nikon-63/Robot_LawnMower/Code/Python/tractor.jpg

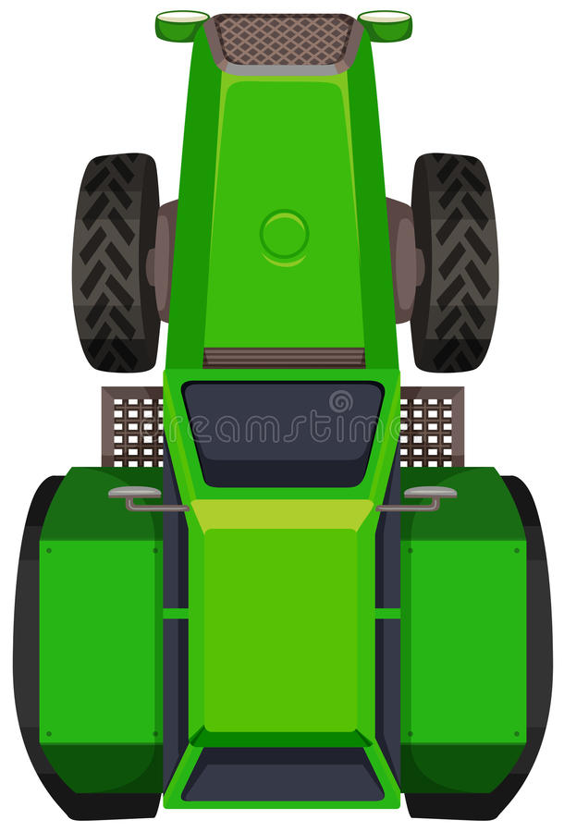
Code/Python/tractor.jpg
