nikon-63/Robot_LawnMower/Image/Hardware.jpeg

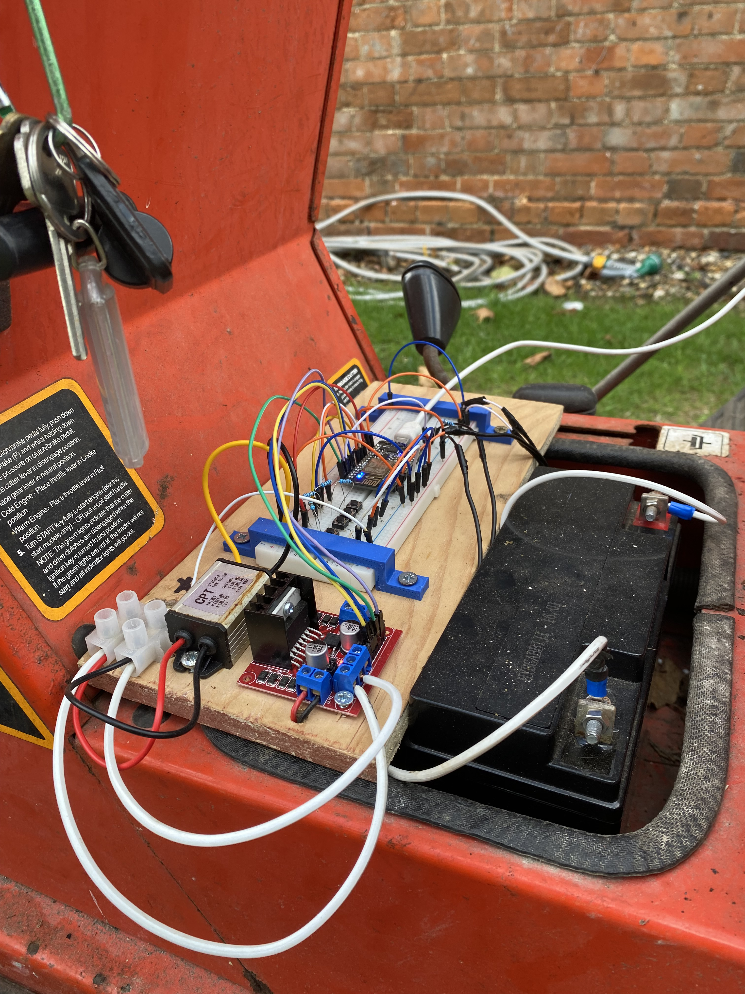
[picture p4: Image/Hardware.jpeg]
Image/Hardware.jpeg
