nikon-63/Robot_LawnMower/Image/L298N.jpeg

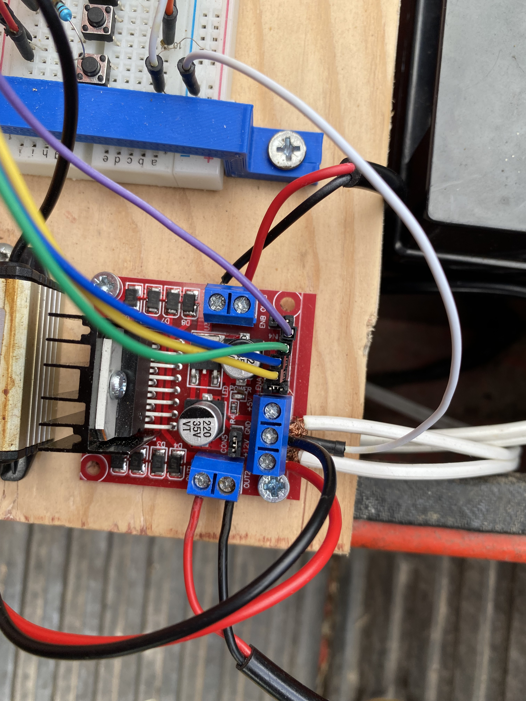
[picture p5: Image/L298N.jpeg]
Image/L298N.jpeg
